emanuel-eckstein/VerteilteSysteme/Bilder/gruen.jpg

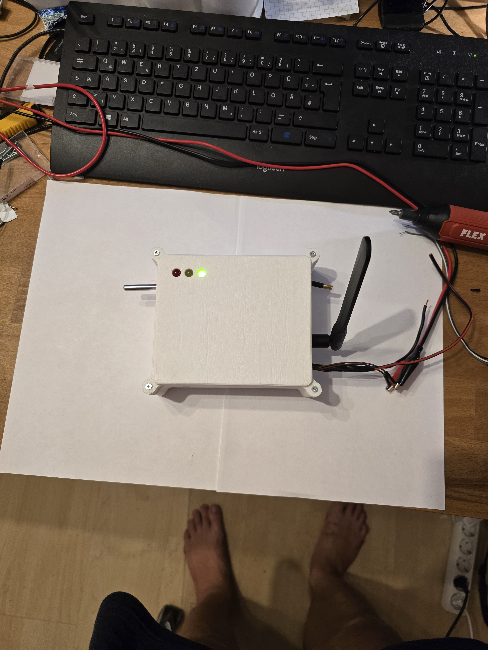
Bilder/gruen.jpg
