emanuel-eckstein/VerteilteSysteme/Bilder/Platine_dia.jpg

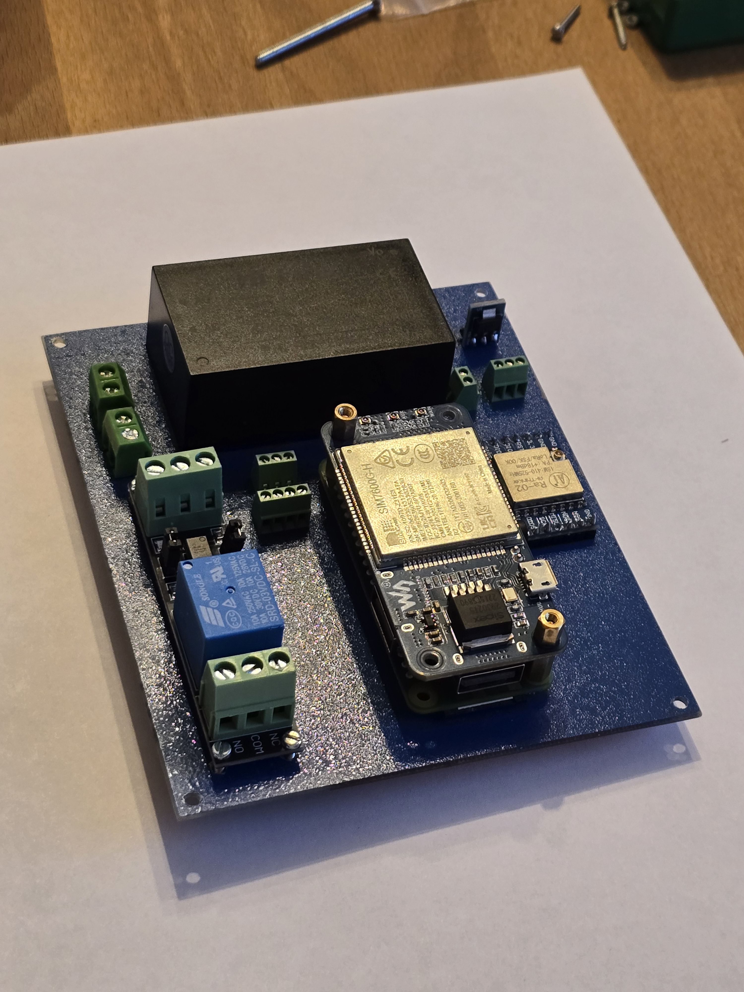
Bilder/Platine_dia.jpg
