emanuel-eckstein/VerteilteSysteme/Bilder/https_hoch_1.png

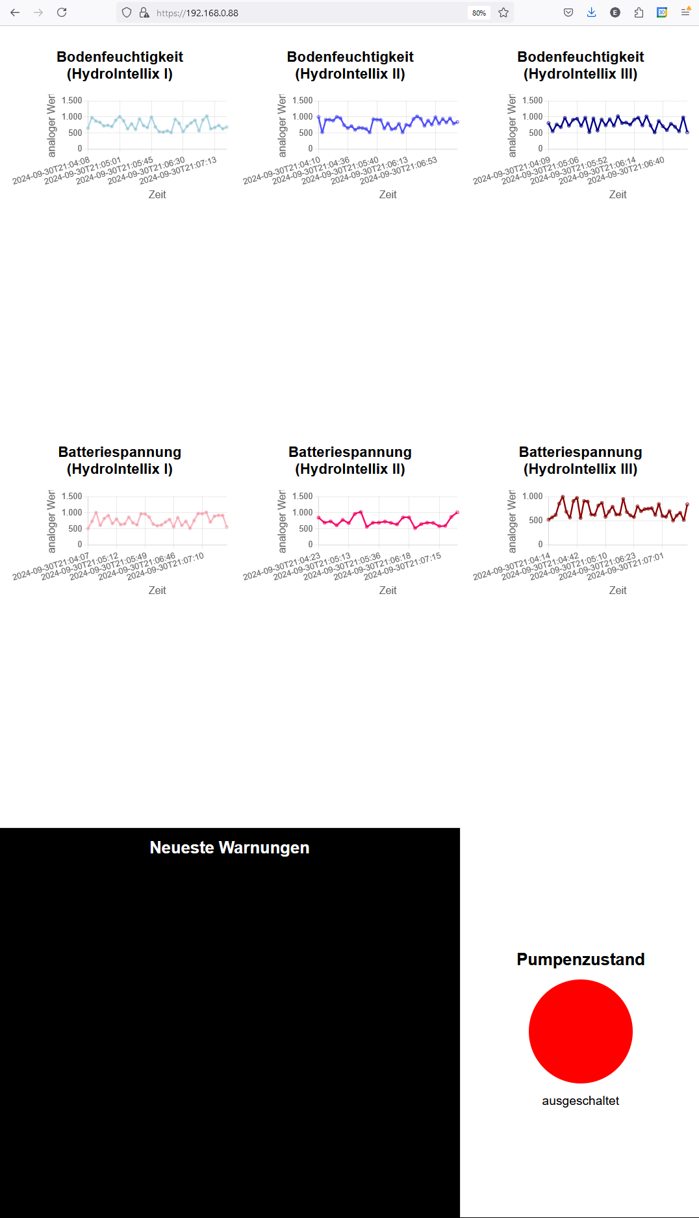
Bilder/https_hoch_1.png
