emanuel-eckstein/VerteilteSysteme/Bilder/https_hoch_2.png

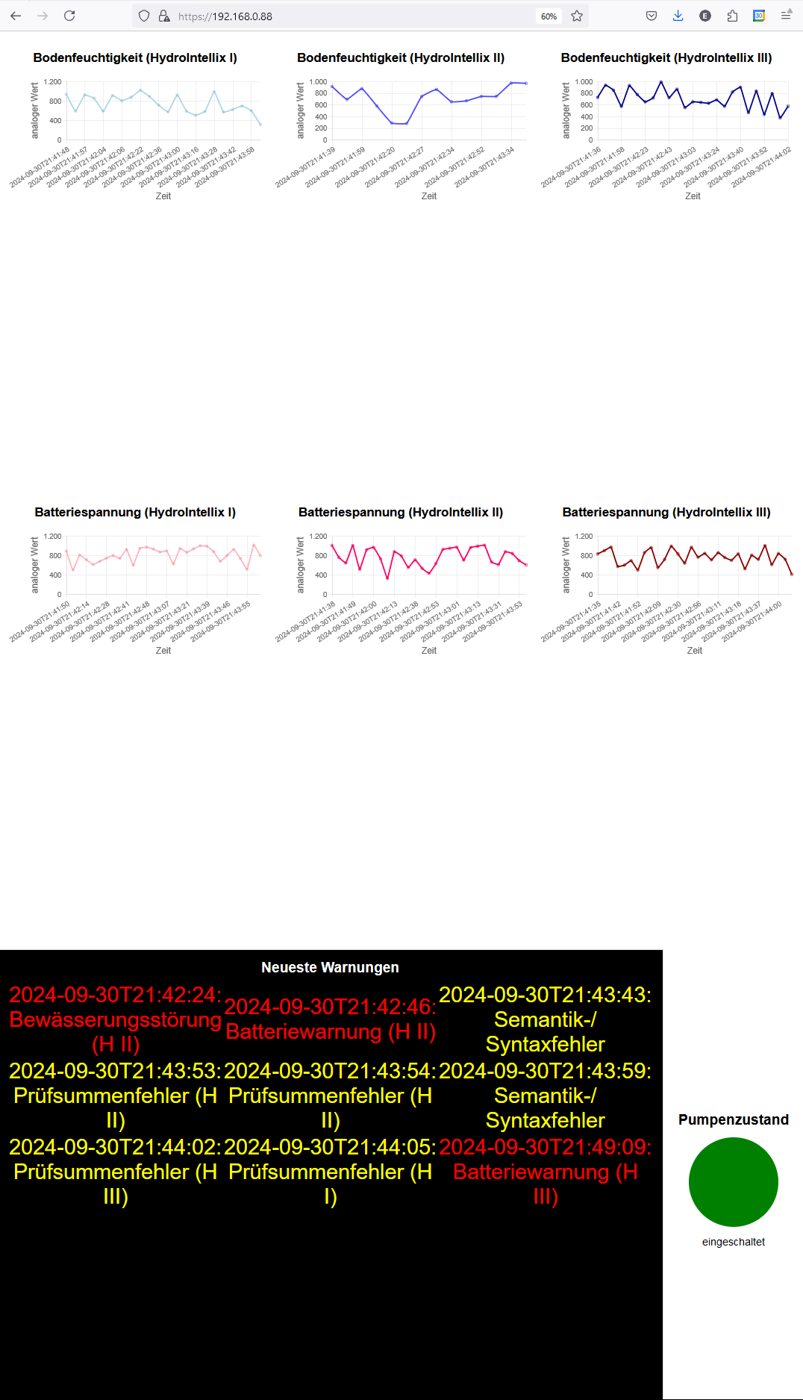
Bilder/https_hoch_2.png
