emanuel-eckstein/VerteilteSysteme/Bilder/https_queer_1.png

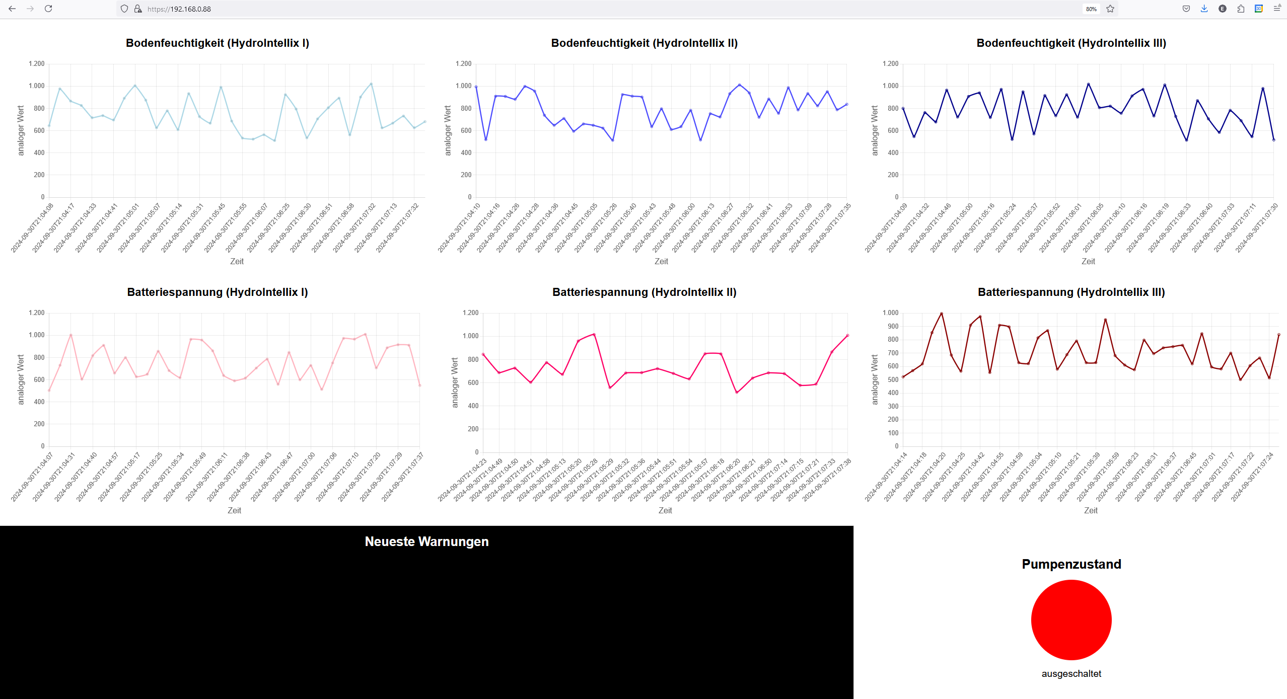
Bilder/https_queer_1.png
