emanuel-eckstein/VerteilteSysteme/Bilder/https_queer_2.png

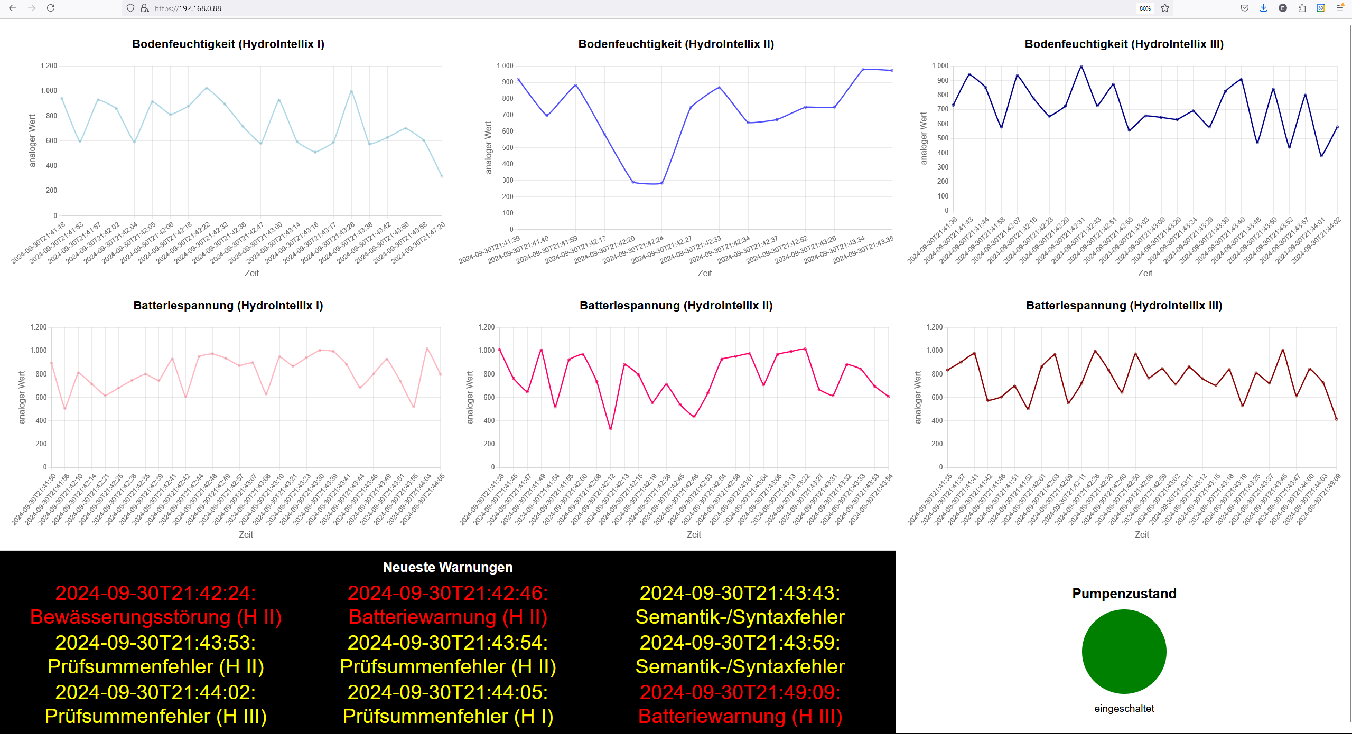
Bilder/https_queer_2.png
