emanuel-eckstein/VerteilteSysteme/Bilder/Leiterplatteneditor.png

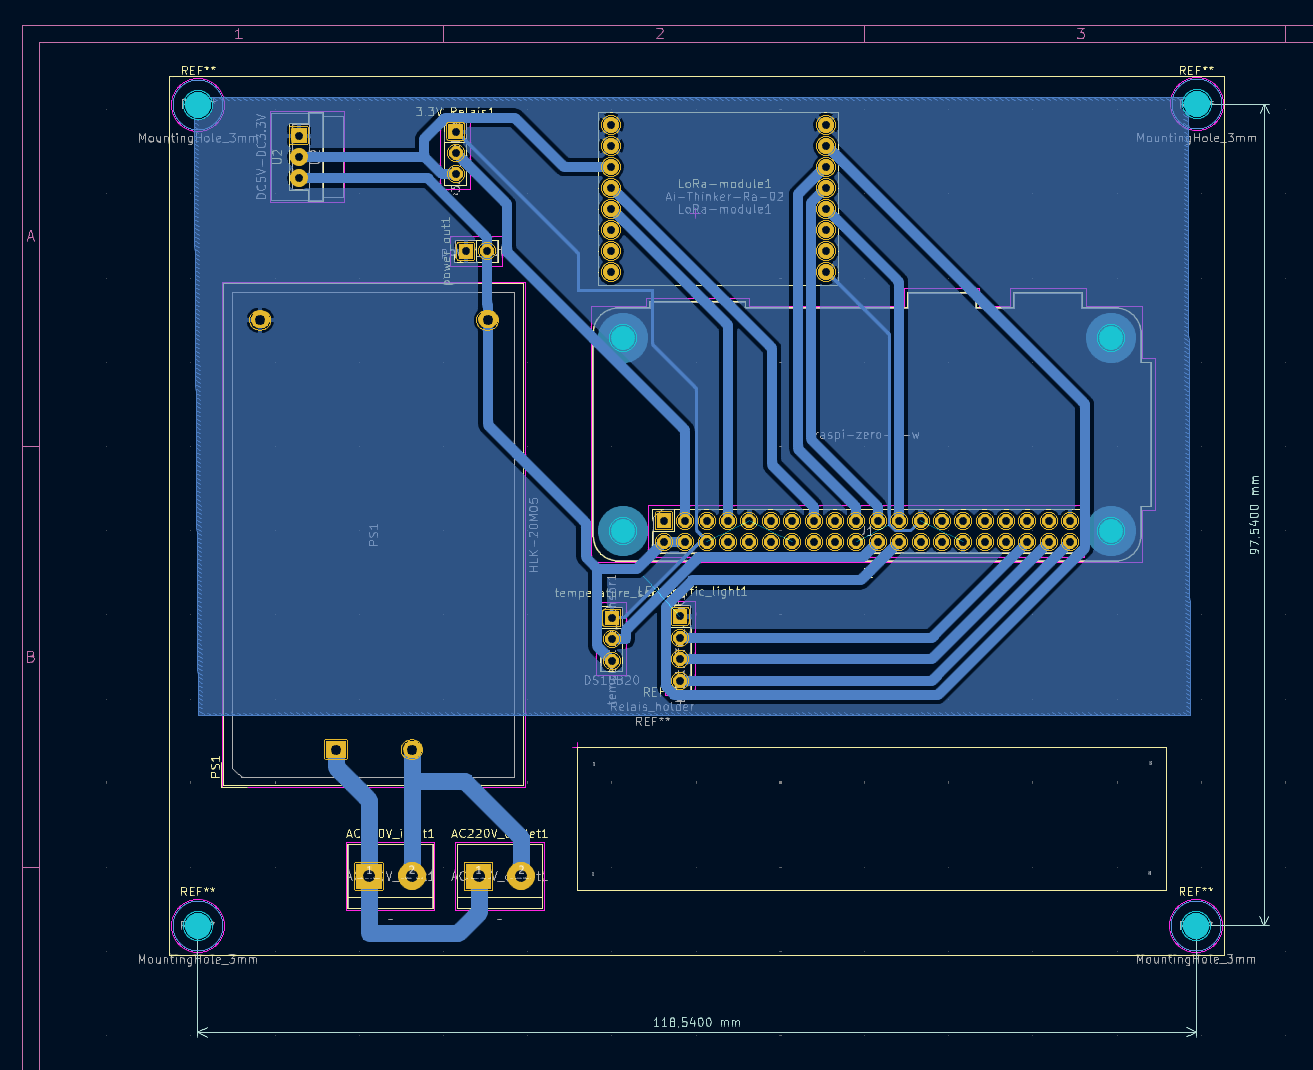
Bilder/Leiterplatteneditor.png
