emanuel-eckstein/VerteilteSysteme/Bilder/Platine_queer.jpg

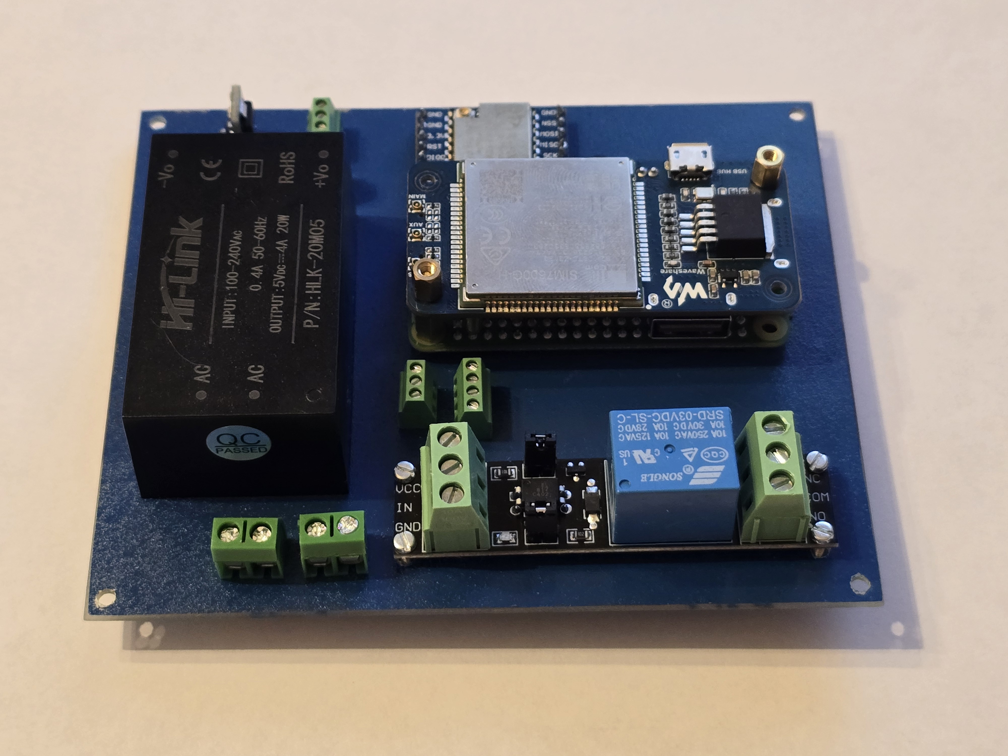
Bilder/Platine_queer.jpg
