emanuel-eckstein/VerteilteSysteme/Bilder/Schaltplan.png

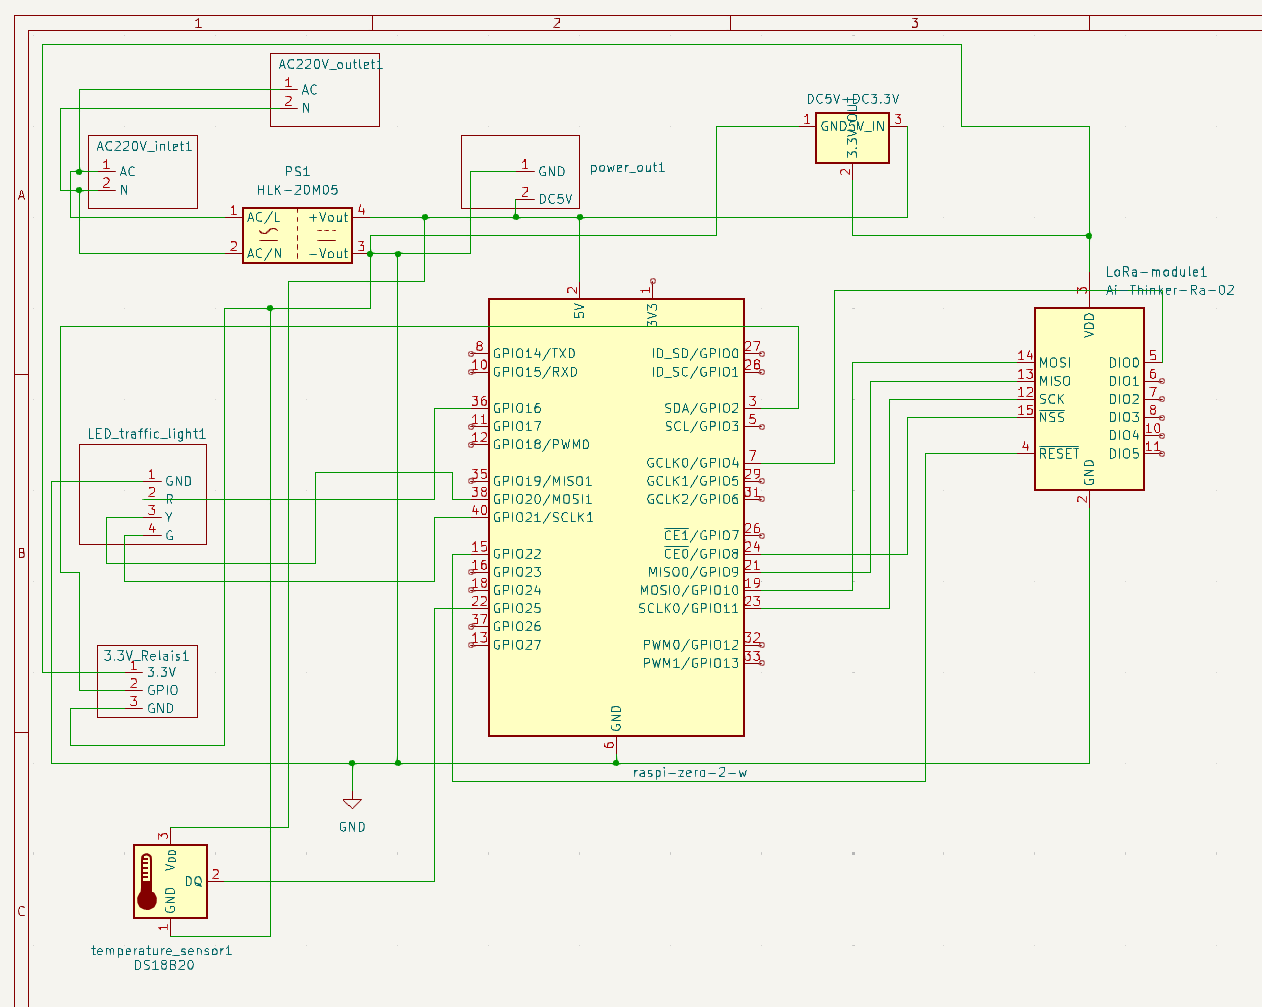
Bilder/Schaltplan.png
