emanuel-eckstein/VerteilteSysteme/electronicsCircuit/hardwareParts/list.txt

###ACDC 220-5V###
https://de.aliexpress.com/item/1005005797445152.html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

###DCDC 5v-3.3V stepdown###
https://www.amazon.de/Heemol-Spannungsregler-Einstellen-Stromversorgungsreglers-Stromversorgung/dp/B0CCS57CL5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

###raspi Zero 2 w###
https://www.berrybase.de/en/raspberry-pi-zero-2-w

###LoRa module###
https://de.aliexpress.com/item/1005004531962944.html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

###4G-HAT###
https://www.berrybase.de/sim7600g-h-4g-hat-b-fuer-raspberry-pi-mobilfunk-und-gnss

###3.3V relais###
https://www.amazon.de/1-Kanal-Relais-Netzschaltermodul-High-Level-Trigger-Optokoppler-Optoisolierung-ESP8266-Entwicklungsboard/dp/B0CN1C1S7Y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

###LED_triple_light###
https://www.amazon.de/APKLVSR-Creative-Mini-Ampel-Ampelmodul-Kompatibel/dp/B0CYH13M9C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
