emanuel-eckstein/VerteilteSysteme/(threads)

Thread 1 (2024-08-18):

electronic circuit design

emanuel-eckstein, 2024-08-18:
development of a circuit to replace the cable-bound prototype
