emanuel-eckstein/VerteilteSysteme/Bilder/pap_programmablauf.pdf

### Programmablaufplan: Pumpenkontrollzentrum

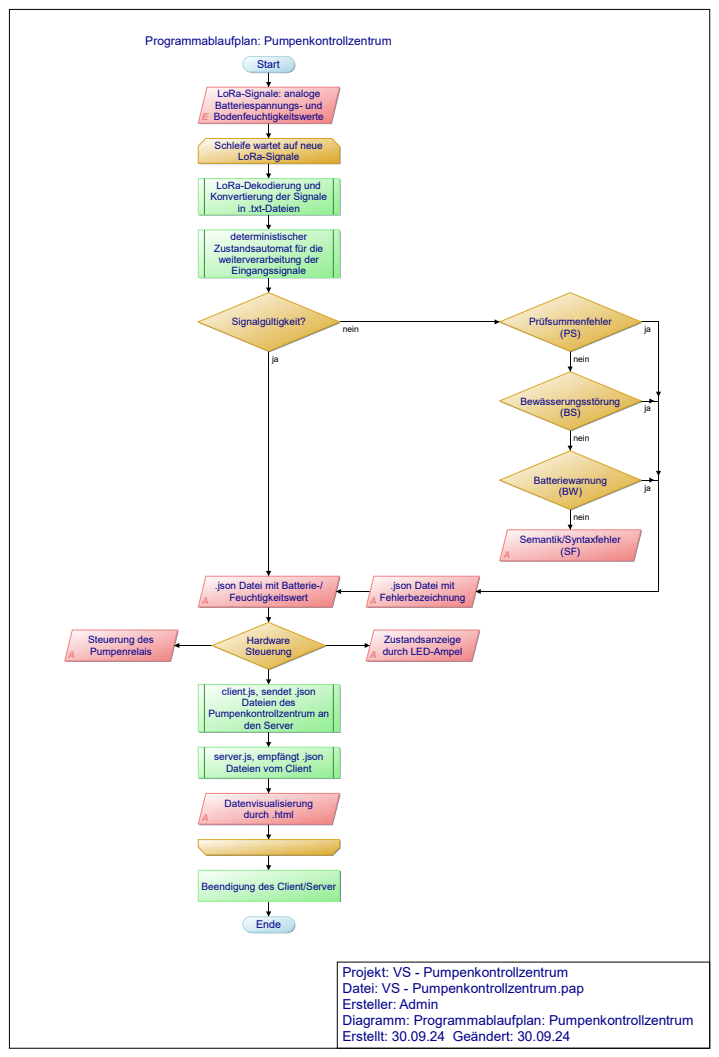
[picture p11: page 1]
nein; Steuerung des Pumpenrelais; Start; Signalgültigkeit?; Hardware Steuerung; Pumpenkontrollzentrum an den Server; Datenvisualisierung durch .html; Ende; .json Datei mit Fehlerbezeichnung; Zustandsanzeige durch LED-Ampel; Prüfsummenfehler (PS); Bewässerungsstörung (BS); Batteriewarnung (BW); Semantik/Syntaxfehler (SF)

LoRa-Signale: analoge
Batteriespannungs- und
Bodenfeuchtigkeitswerte

Schleife wartet auf neue
LoRa-Signale

LoRa-Dekodierung und
Konvertierung der Signale
in .txt-Dateien

deterministischer
Zustandsautomat für die
weiterverarbeitung der
Eingangssignale

.json Datei mit Batterie-/
Feuchtigkeitswert

client.js, sendet .json
Dateien des

server.js, empfängt .json
Dateien vom Client

Beendigung des Client/Server

Projekt: VS - Pumpenkontrollzentrum
Datei: VS - Pumpenkontrollzentrum.pap
Ersteller: Admin
Diagramm: Programmablaufplan: Pumpenkontrollzentrum
Erstellt: 30.09.24 Geändert: 30.09.24
