emanuel-eckstein/VerteilteSysteme/Bilder/aufgabenstellung.pdf

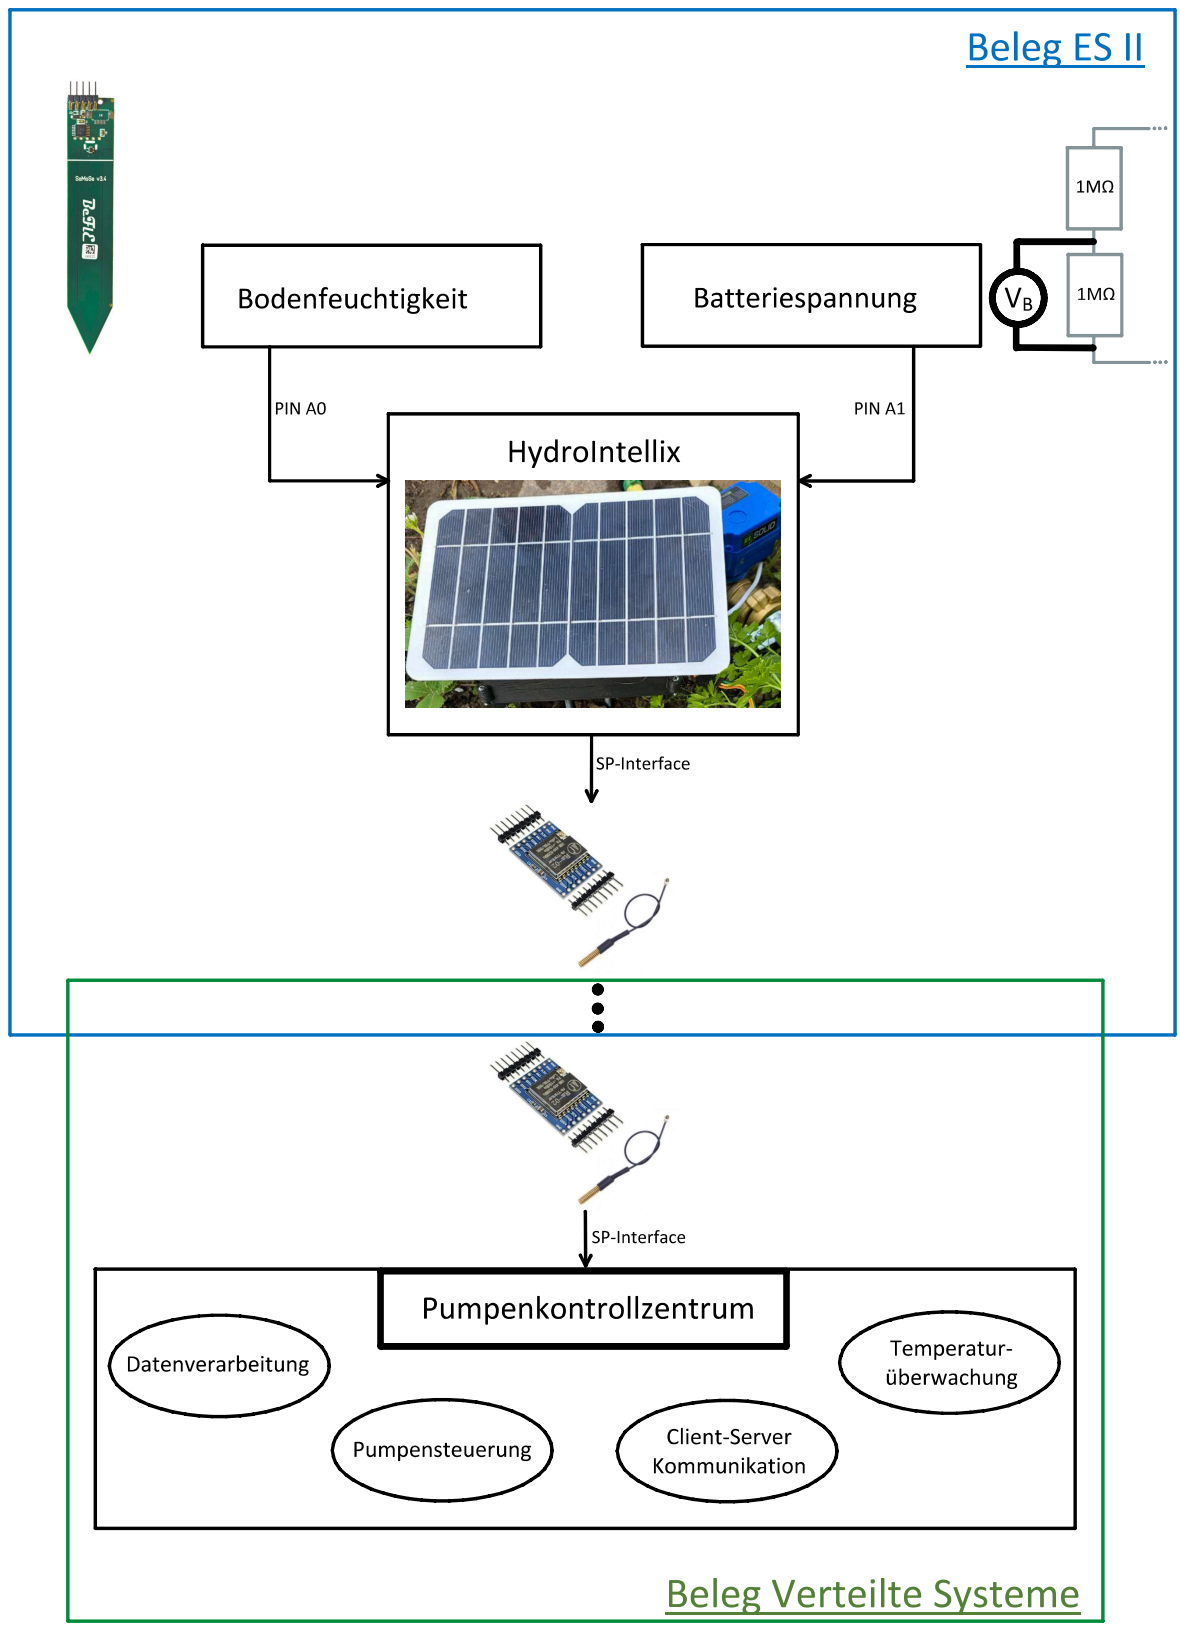
[picture p12: page 1]
