emanuel-eckstein/VerteilteSysteme/electronicsCircuit/MK1/MK1.kicad_pcb

## KiCad design electronicsCircuit/MK1/MK1.kicad_pcb (2024-08-23)

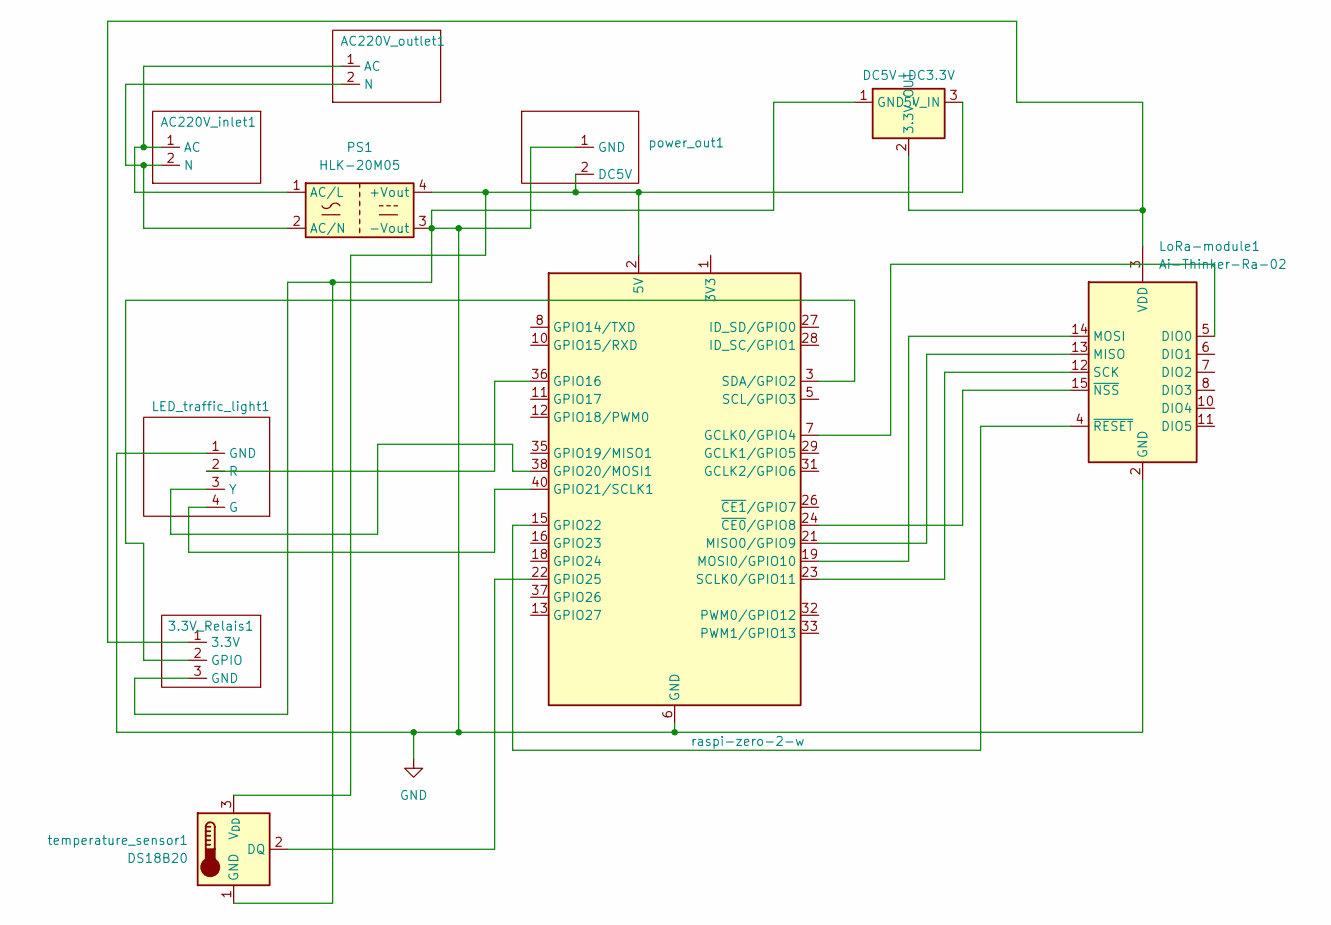
[picture p13: schematic MK1.kicad_sch]

Parts:
3.3V_Relais1: PinHeader_1x03_P2.54mm_Vertical
AC220V_inlet1, AC220V_outlet1: TerminalBlock_bornier-2_P5.08mm
J1: raspi-zero-2-w; Raspberry_Pi_Zero_Socketed_THT_FaceDown_MountingHoles
LED_traffic_light1: PinHeader_1x04_P2.54mm_Vertical
LoRa-module1: Ai-Thinker-Ra-02; LoRa2
PS1: HLK-20M05; Converter_ACDC_Hi-Link_HLK-20Mxx
U2: DC5V-DC3.3V; Converter_DCDC_Murata_OKI-78SR_Vertical
power_out1: PinHeader_1x02_P2.54mm_Vertical
temperature_sensor1: DS18B20; PinHeader_1x03_P2.54mm_Vertical

Connections:
GND: 3.3V_Relais1.3 (GND), J1.6 (GND), J1.9 (GND), J1.14 (GND), J1.20 (GND), J1.25 (GND), J1.30 (GND), J1.34 (GND), J1.39 (GND), LED_traffic_light1.1 (GND), LoRa-module1.1 (GND), LoRa-module1.2 (GND), LoRa-module1.9 (GND), LoRa-module1.16 (GND), PS1.3 (-Vout), U2.1 (GND), power_out1.1 (GND), temperature_sensor1.1 (GND)
unnamed: 3.3V_Relais1.1 (3.3V), LoRa-module1.3 (VDD), U2.2 (3.3V_OUT)
unnamed: 3.3V_Relais1.2 (GPIO), J1.3 (SDA/GPIO2)
unnamed: AC220V_inlet1.1 (AC), AC220V_outlet1.1 (AC), PS1.1 (AC/L)
unnamed: AC220V_inlet1.2 (N), AC220V_outlet1.2 (N), PS1.2 (AC/N)
unnamed: J1.1 (3V3), J1.17 (3V3)
unnamed: J1.7 (GCLK0/GPIO4), LoRa-module1.5 (DIO0)
unnamed: J1.36 (GPIO16), LED_traffic_light1.2 (R)
unnamed: J1.38 (GPIO20/MOSI1), LED_traffic_light1.3 (Y)
unnamed: J1.40 (GPIO21/SCLK1), LED_traffic_light1.4 (G)
unnamed: J1.15 (GPIO22), LoRa-module1.4 (~RESET)
unnamed: J1.22 (GPIO25), temperature_sensor1.2 (DQ)
unnamed: J1.21 (MISO0/GPIO9), LoRa-module1.13 (MISO)
unnamed: J1.19 (MOSI0/GPIO10), LoRa-module1.14 (MOSI)
unnamed: J1.23 (SCLK0/GPIO11), LoRa-module1.12 (SCK)
unnamed: J1.24 (~CE0/GPIO8), LoRa-module1.15 (~NSS)
unnamed: J1.2 (5V), J1.4 (5V), PS1.4 (+Vout), U2.3 (5V_IN), power_out1.2 (DC5V), temperature_sensor1.3 (V_{DD})

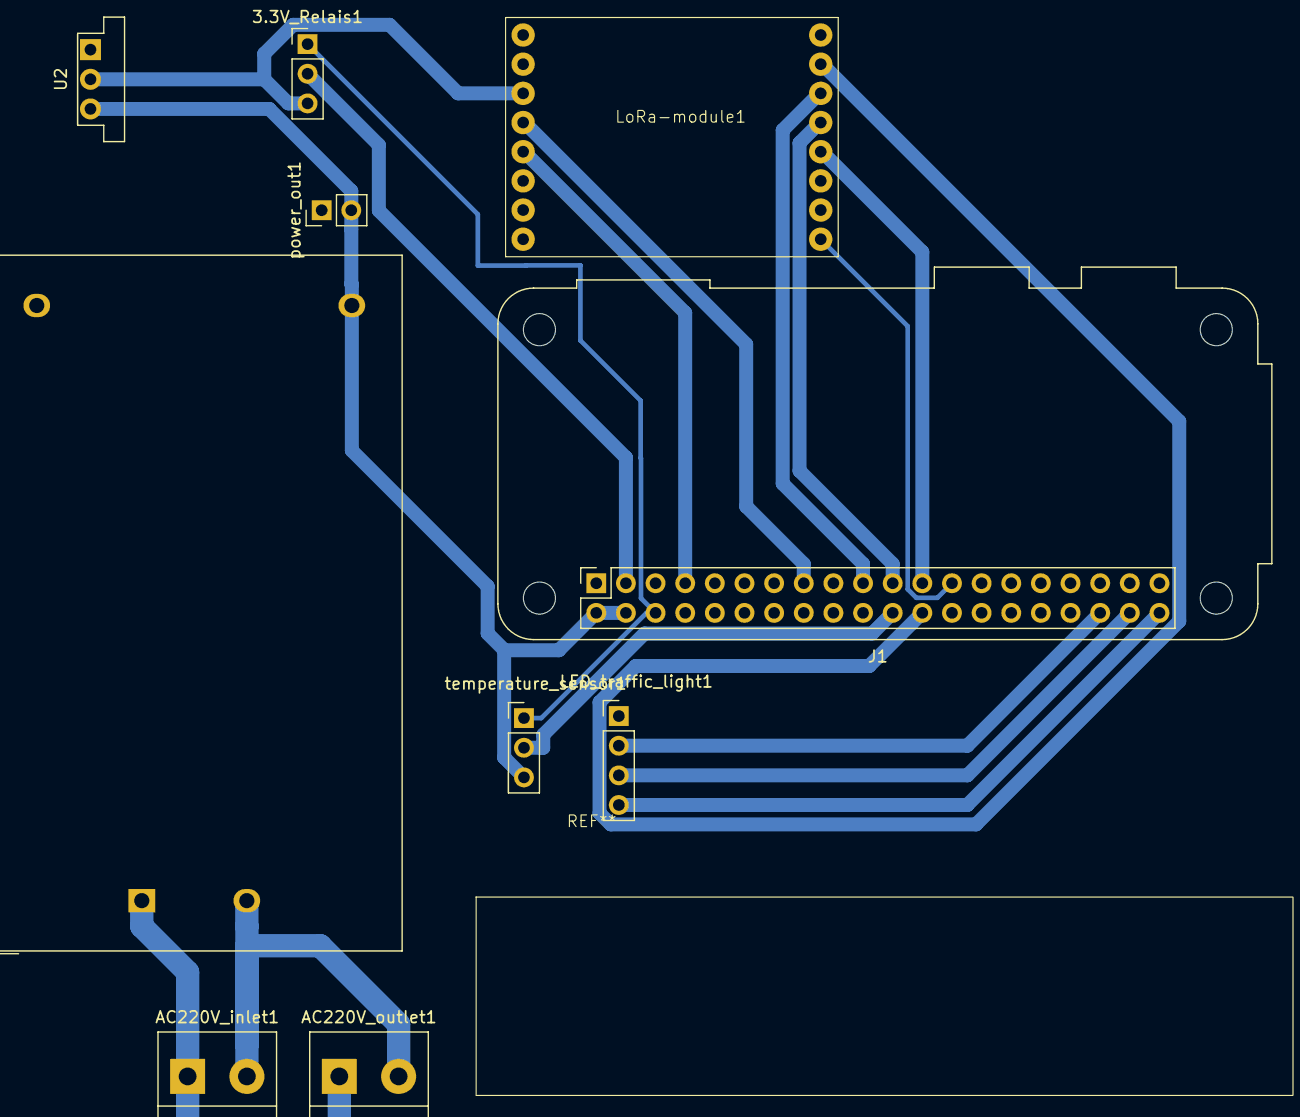
[picture p14: board MK1.kicad_pcb from above]

Board: 2 copper layers, 10 parts (0 on the bottom side), 17 nets.
