emanuel-eckstein/VerteilteSysteme/(commit log)

2024-08-23 big push
    [MK1-B_Cu.gbr, MK1-B_Mask.gbr, MK1-B_Paste.gbr, MK1-B_Silkscreen.gbr, MK1-Edge_Cuts.gbr, MK1-F_Cu.gbr, MK1-F_Mask.gbr, MK1-F_Paste.gbr]
2024-09-28 different files added
    [MK2.kicad_pcb]
2024-09-30 alles neu
    [MK1.kicad_sch, pyvenv.cfg]
