emanuel-eckstein/VerteilteSysteme/Bilder/offen_dia.jpg

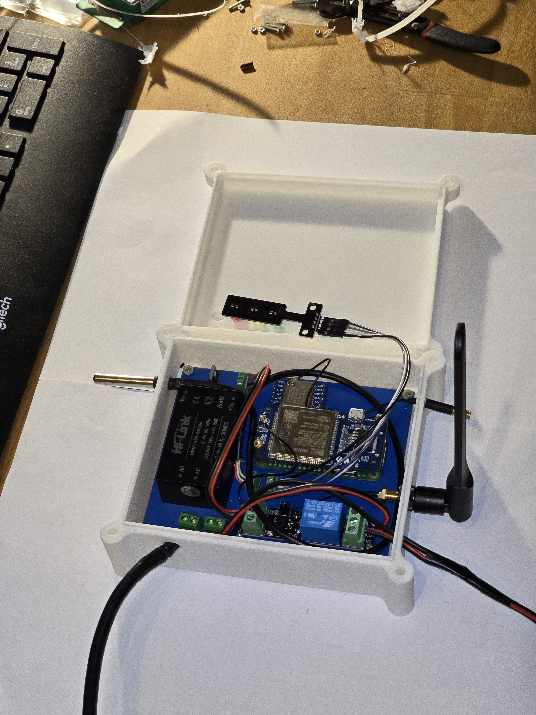
Bilder/offen_dia.jpg
